Antiemes/Voice_caller/README.md

# Voice_caller
Voice caller aka. pofazogep
