Antiemes/Voice_caller/3d/voicecaller-box_top.stl

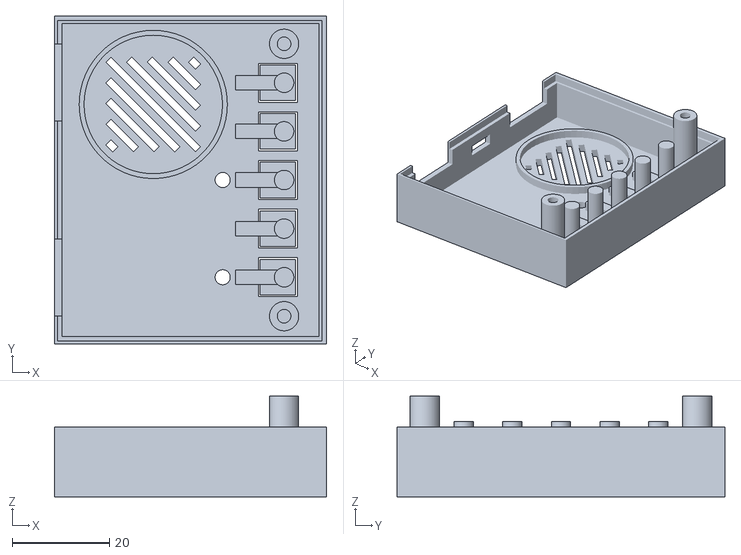
[picture p3: CAD file, 2021-05-10]
3d/voicecaller-box_top.stl
55.8 x 67.2 x 20.7
