Antiemes/Voice_caller/3d/voicecaller-box_bottom.stl

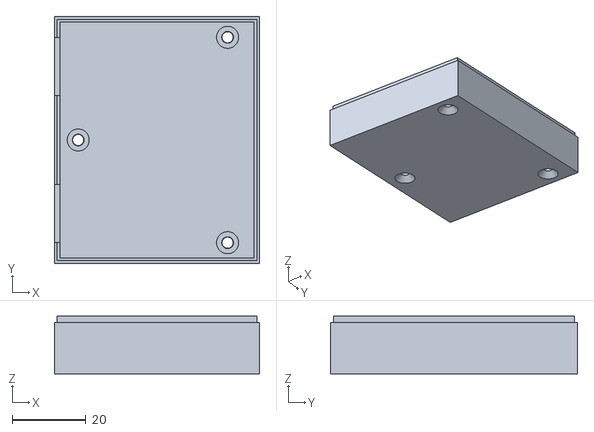
[picture p4: CAD file, 2021-05-10]
3d/voicecaller-box_bottom.stl
55.8 x 67.2 x 15.7
