Antiemes/Voice_caller/pcb/yaesu/voice_caller.brd

## EAGLE design pcb/yaesu/voice_caller.brd (2020-07-21)

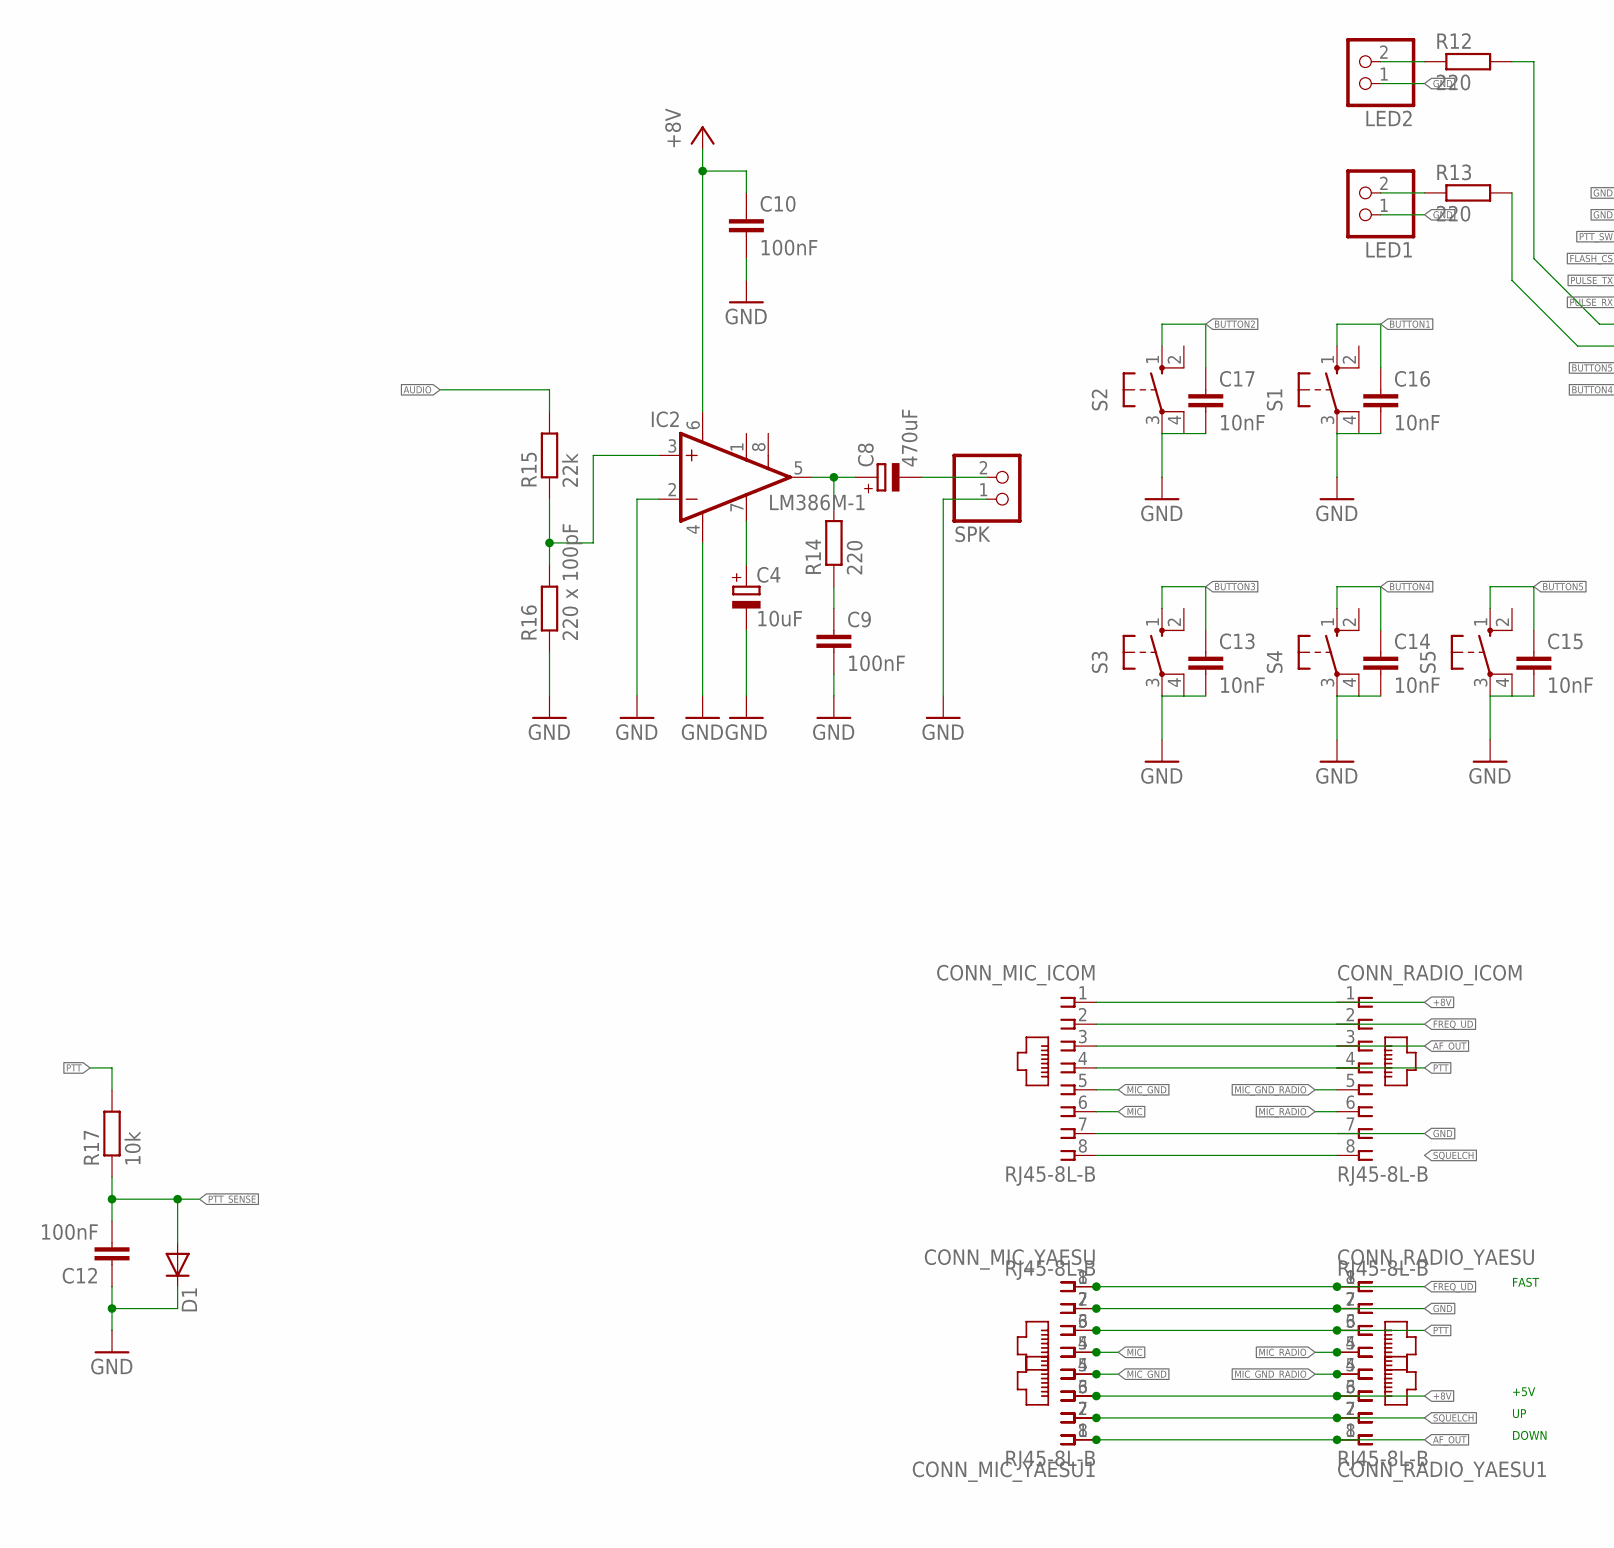
[picture p5: schematic voice_caller.sch, part in row 1, column 1]

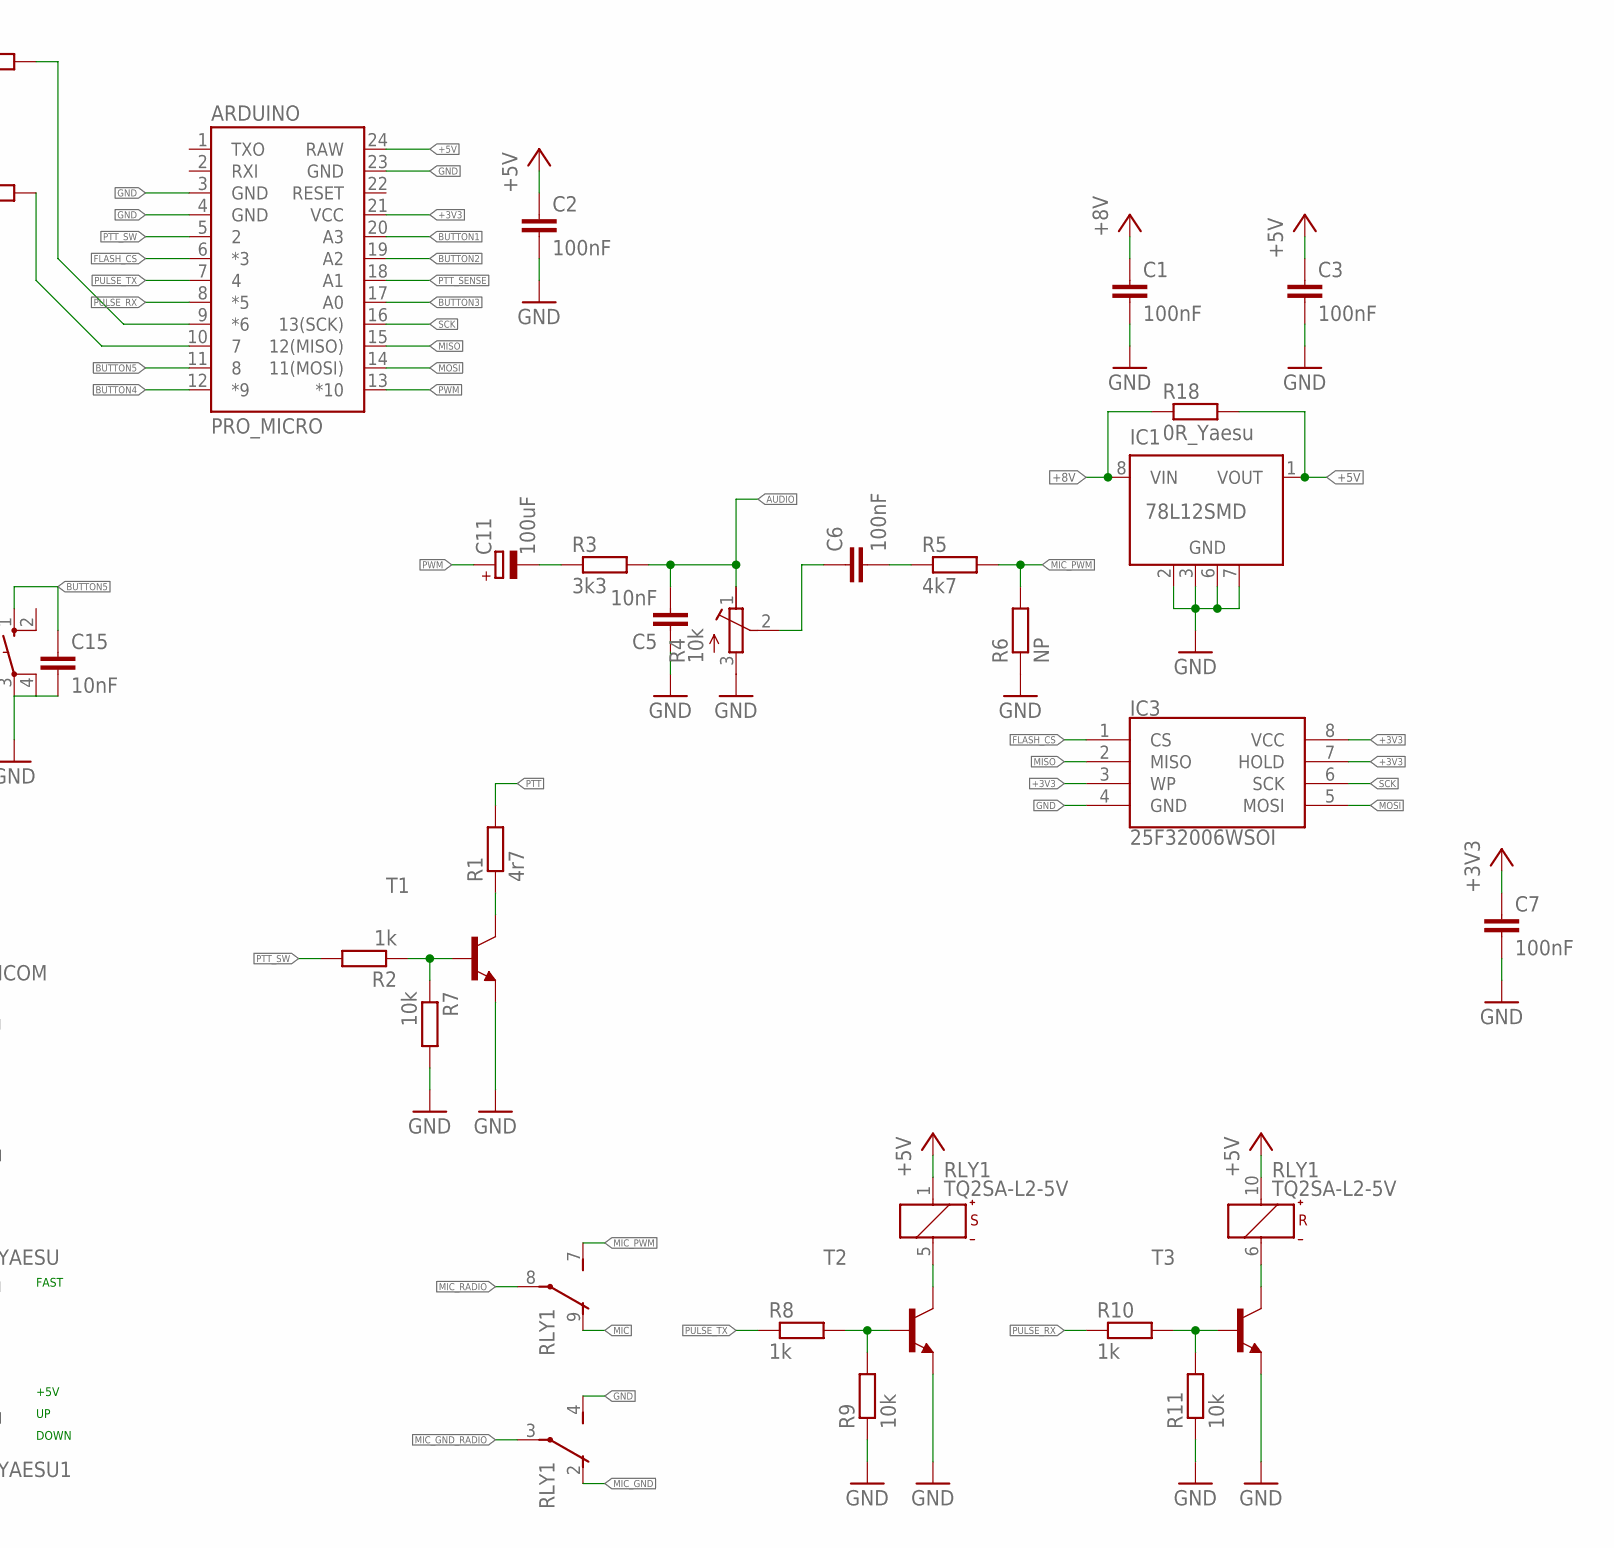
[picture p6: schematic voice_caller.sch, part in row 1, column 2]

Parts:
ARDUINO: PRO_MICRO; SPARKFUN_PRO_MICRO
C1, C2, C3, C6, C7, C9, C10, C12: 100nF; C1206K
C4: 10uF; E2,5-6
C5, C13, C14, C15, C16, C17: 10nF; C1206K
C8: 470uF; E2,5-6
C11: 100uF; E2,5-6
CONN_MIC_ICOM: RJ45-8L-B; RJ45-NO-SHIELD
CONN_MIC_YAESU, CONN_MIC_YAESU1: RJ45-8L-B; RJ45-NO-SHIELD
CONN_RADIO_ICOM: RJ45-8L-B; RJ45-NO-SHIELD
CONN_RADIO_YAESU, CONN_RADIO_YAESU1: RJ45-8L-B; RJ45-NO-SHIELD
D1: DIODE-SOD80C; SOD80C
IC1: 78L12SMD; SO08
IC2: LM386M-1; SO08
IC3: 25F32006WSOI; SO08-EIAJ
LED1, LED2: PINHD-1X2; 1X02
R1: 4r7; M1206
R2, R8, R10: 1k; M1206
R3: 3k3; M1206
R4: 10k; RTRIMT93XB
R5: 4k7; M1206
R6: NP; M1206
R7, R9, R11, R17: 10k; M1206
R12, R13, R14: 220; M1206
R15: 22k; M1206
R16: 220 x 100pF; M1206
R18: 0R_Yaesu; M1206
RLY1: TQ2SA-L2-5V; TQ-SA
S1, S2, S3, S4, S5: 10-XX; B3F-10XX
SPK: PINHD-1X2; 1X02
T1, T2, T3: MMBT3904LT1-NPN-SOT23-BEC; SOT23-BEC

Connections:
+3V3: ARDUINO.21 (VCC), C7.1, IC3.3 (WP), IC3.7 (HOLD), IC3.8 (VCC)
+5V: ARDUINO.24 (RAW), C2.1, C3.1, IC1.1 (VOUT), R18.2, RLY1.1 (+), RLY1.10 (+)
+8V: C1.1, C10.1, CONN_MIC_ICOM.1, CONN_MIC_YAESU.6, CONN_MIC_YAESU1.3, CONN_RADIO_ICOM.1, CONN_RADIO_YAESU.6, CONN_RADIO_YAESU1.3, IC1.8 (VIN), IC2.6 (VS), R18.1
AF_OUT: CONN_MIC_ICOM.3, CONN_MIC_YAESU.8, CONN_MIC_YAESU1.1, CONN_RADIO_ICOM.3, CONN_RADIO_YAESU.8, CONN_RADIO_YAESU1.1
AUDIO: C5.2, R3.2, R4.1 (E), R15.2
BUTTON1: ARDUINO.20 (A3), C16.1, S1.1 (S)
BUTTON2: ARDUINO.19 (A2), C17.1, S2.1 (S)
BUTTON3: ARDUINO.17 (A0), C13.1, S3.1 (S)
BUTTON4: ARDUINO.12 (*9), C14.1, S4.1 (S)
BUTTON5: ARDUINO.11 (8), C15.1, S5.1 (S)
FLASH_CS: ARDUINO.6 (*3), IC3.1 (CS)
FREQ_UD: CONN_MIC_ICOM.2, CONN_MIC_YAESU.1, CONN_MIC_YAESU1.8, CONN_RADIO_ICOM.2, CONN_RADIO_YAESU.1, CONN_RADIO_YAESU1.8
GND: ARDUINO.3 (GND), ARDUINO.4 (GND), ARDUINO.23 (GND), C1.2, C2.2, C3.2, C4.-, C5.1, C7.2, C9.2, C10.2, C12.1, C13.2, C14.2, C15.2, C16.2, C17.2, CONN_MIC_ICOM.7, CONN_MIC_YAESU.2, CONN_MIC_YAESU1.7, CONN_RADIO_ICOM.7, CONN_RADIO_YAESU.2, CONN_RADIO_YAESU1.7, D1.C, IC1.2 (GND), IC1.3 (GND), IC1.6 (GND), IC1.7 (GND), IC2.2 (-IN), IC2.4 (GND), IC3.4 (GND), LED1.1, LED2.1, R4.3 (A), R6.1, R7.2, R9.1, R11.1, R16.1, RLY1.4 (S), S1.3, S1.4 (P1), S2.3, S2.4 (P1), S3.3, S3.4 (P1), S4.3, S4.4 (P1), S5.3, S5.4 (P1), SPK.1, T1.E, T2.E, T3.E
MIC: CONN_MIC_ICOM.6, CONN_MIC_YAESU.4, CONN_MIC_YAESU1.5, RLY1.9 (O)
MIC_GND: CONN_MIC_ICOM.5, CONN_MIC_YAESU.5, CONN_MIC_YAESU1.4, RLY1.2 (O)
MIC_GND_RADIO: CONN_RADIO_ICOM.5, CONN_RADIO_YAESU.5, CONN_RADIO_YAESU1.4, RLY1.3
MIC_PWM: R5.2, R6.2, RLY1.7 (S)
MIC_RADIO: CONN_RADIO_ICOM.6, CONN_RADIO_YAESU.4, CONN_RADIO_YAESU1.5, RLY1.8
MISO: ARDUINO.15 (12(MISO)), IC3.2 (MISO)
MOSI: ARDUINO.14 (11(MOSI)), IC3.5 (MOSI)
unnamed: C11.-, R3.1
unnamed: IC2.3 (+IN), R15.1, R16.2
unnamed: C6.2, R5.1
unnamed: LED2.2, R12.1
unnamed: R2.1, R7.1, T1.B
unnamed: C6.1, R4.2 (S)
unnamed: C4.+, IC2.7 (BYPASS)
unnamed: R1.1, T1.C
unnamed: LED1.2, R13.1
unnamed: RLY1.5 (-), T2.C
unnamed: R8.2, R9.2, T2.B
unnamed: ARDUINO.9 (*6), R12.2
unnamed: RLY1.6 (-), T3.C
unnamed: R10.2, R11.2, T3.B
unnamed: ARDUINO.10 (7), R13.2
unnamed: C8.+, IC2.5 (OUT), R14.2
unnamed: C9.1, R14.1
unnamed: C8.-, SPK.2
PTT: CONN_MIC_ICOM.4, CONN_MIC_YAESU.3, CONN_MIC_YAESU1.6, CONN_RADIO_ICOM.4, CONN_RADIO_YAESU.3, CONN_RADIO_YAESU1.6, R1.2, R17.2
PTT_SENSE: ARDUINO.18 (A1), C12.2, D1.A, R17.1
PTT_SW: ARDUINO.5 (2), R2.2
PULSE_RX: ARDUINO.8 (*5), R10.1
PULSE_TX: ARDUINO.7 (4), R8.1
PWM: ARDUINO.13 (*10), C11.+
SCK: ARDUINO.16 (13(SCK)), IC3.6 (SCK)
SQUELCH: CONN_MIC_ICOM.8, CONN_MIC_YAESU.7, CONN_MIC_YAESU1.2, CONN_RADIO_ICOM.8, CONN_RADIO_YAESU.7, CONN_RADIO_YAESU1.2

Notes on the sheet:
FAST
+5V
DOWN

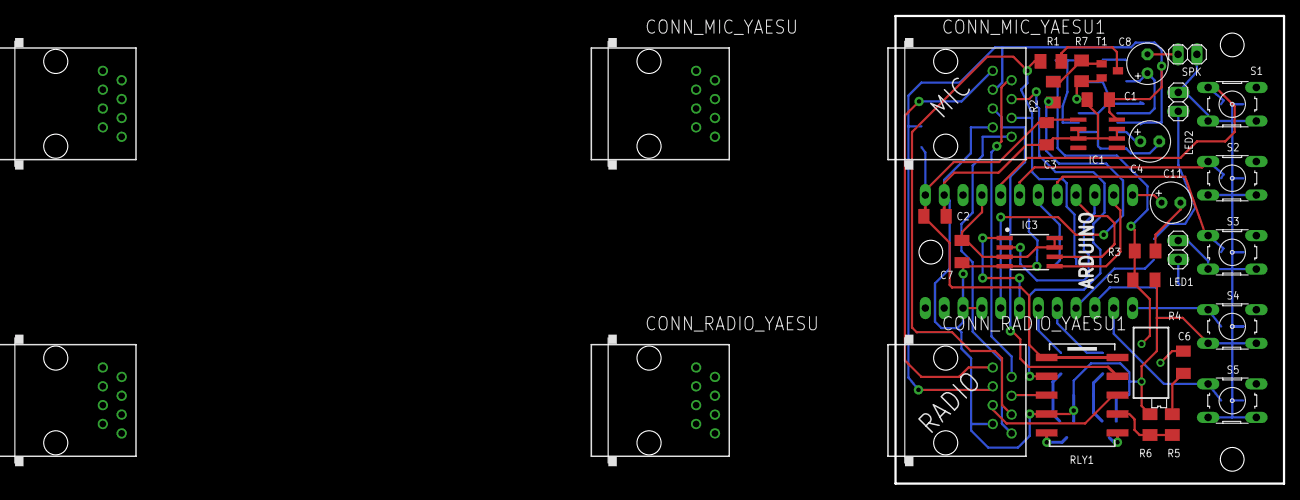
[picture p7: board voice_caller.brd from above]

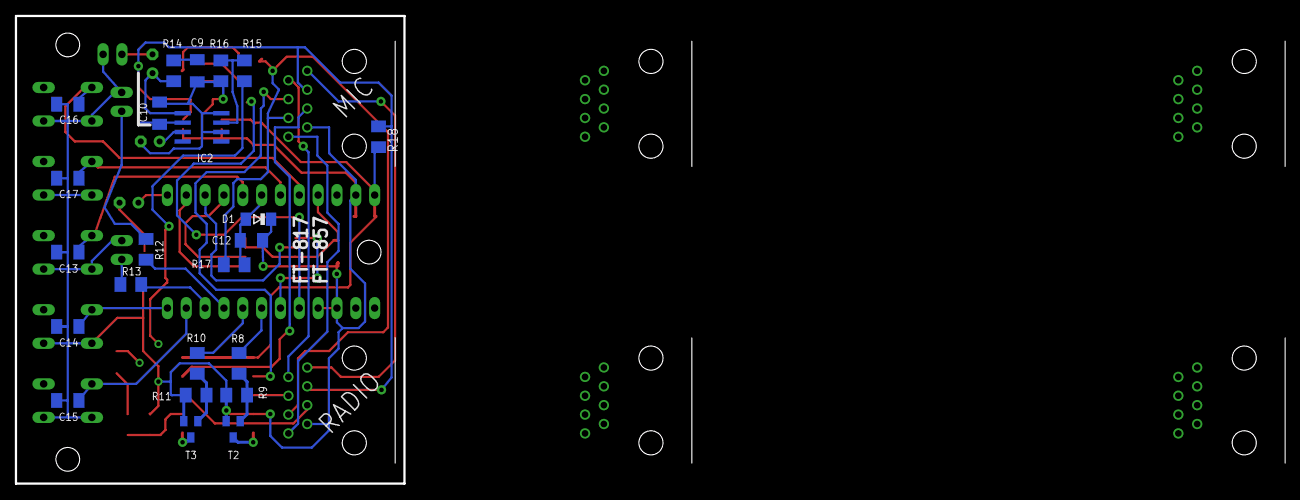
[picture p8: board voice_caller.brd from below]

Board: 2 copper layers, 52.4 x 63.1 mm, 58 parts (23 on the bottom side), 46 nets.
