Antiemes/Voice_caller/(commit log)

2019-01-29 Arduino nano lib added
2019-01-31 PCB first sketch added
    [voice_caller.brd, voice_caller.sch]
2019-02-04 Who knows
    [voice_caller.brd, voice_caller.sch]
2019-02-09 Pro micro board added
2019-02-09 Nano changed to pro micro
    [voice_caller.brd, voice_caller.sch]
2019-02-11 RJ-45 connected
    [voice_caller.brd, voice_caller.sch]
2019-05-05 Some progress with the PCB
    [voice_caller.brd, voice_caller.sch]
2019-05-05 More progress with the PCB
    [voice_caller.brd, voice_caller.sch]
2019-05-06 All but switches
    [voice_caller.brd, voice_caller.sch]
2019-05-09 Buttons and bistable relay added, PTT thing is missing.
    [voice_caller.brd, voice_caller.sch]
2019-05-10 PTT circuit added
    [voice_caller.brd, voice_caller.sch]
2019-05-10 Analog pins modified
    [voice_caller.brd, voice_caller.sch]
2019-07-12 Routing done
    [voice_caller.brd]
2019-07-12 Headers for LEDs added
    [voice_caller.brd, voice_caller.sch]
2019-07-12 Mounting holes
    [voice_caller.brd]
2019-08-04 Missing nets for flash routed.
    [voice_caller.brd, voice_caller.sch]
2019-08-04 RC values added.
    [voice_caller.brd, voice_caller.sch]
2019-08-06 SPI pins changed according to Pro Micro.
2019-08-06 Wiring in repeating the audio playback.
2019-08-07 PWM settings for new pin.
2019-08-07 LED settings added.
2019-08-07 Relay GPIO initialization
2019-08-07 PTT switch code.
2019-08-07 Arduino platfrom removed.
2019-08-09 Relay functions added.
2019-08-09 Relay control added.
2019-08-09 Values adjusted.
    [voice_caller.brd, voice_caller.sch]
2019-08-11 Timer frequency is now correct.
    [main.c]
2019-08-13 Flash IC replaced and almost routed.
    [voice_caller.brd, voice_caller.sch]
2019-08-15 Flash routed, PTT sense changed.
    [voice_caller.brd, voice_caller.sch]
2019-08-15 Monitor amp added and routed.
    [voice_caller.brd, voice_caller.sch]
2019-08-15 Bypass capacitor added for LM386.
    [voice_caller.brd, voice_caller.sch]
2019-08-22 PTT sensing circuity added.
    [voice_caller.brd, voice_caller.sch]
2019-08-22 Filter capacitors added to pushbuttons
    [voice_caller.brd, voice_caller.sch]
2019-08-22 RJ-45 connectors moves 1.3mm inwards.
    [voice_caller.brd]
2019-09-03 Final adjustments.
    [voice_caller.brd, voice_caller.sch]
2019-10-24 AF amp attenuator changed.
    [voice_caller.brd, voice_caller.sch]
2019-10-24 Jumper wire added.
    [voice_caller.brd, voice_caller.sch]
2019-11-05 A big issue with timing was fixed.
    [main.c]
2019-11-05 Attenuator changed, Yaesu connector added.
    [voice_caller.brd, voice_caller.sch]
2019-11-28 Pot. value added.
    [voice_caller.brd, voice_caller.sch]
2020-05-28 SampleCounter clash removed
2020-07-08 Icom version moved to another folder.
    [voice_caller.brd, voice_caller.sch]
2020-07-08 Yaesu version.
    [voice_caller.brd, voice_caller.sch]
2020-07-21 Connector connections corredted.
    [voice_caller.brd, voice_caller.sch]
2021-05-10 3D printed enclosure added
    [voicecaller-box_bottom.scad, voicecaller-box_bottom.stl, voicecaller-box_top.scad, voicecaller-box_top.stl]
2021-07-07 Style changed
    [voicecaller-box_bottom.scad]
2021-07-07 Magnets added
    [voicecaller-box_bottom_magnets.scad]
2023-08-14 Bigger speaker
    [voicecaller-box_top.scad]
